dosdude1/MPx-CPU-Board-744x/README.md

# MPx CPU Board 744x
A custom CPU board designed for Power Macintosh G4 systems. This board is designed for use with 744x-series PowerPC G4 CPUs, such as the 7445, 7447, and 7448.

This repository is a work in progress, the design is not in a functional state at this point.
