dosdude1/MPx-CPU-Board-744x/MPx-CPU-Board-Dual-744x/cpu-misc.kicad_sch

## KiCad design MPx-CPU-Board-Dual-744x/cpu-misc.kicad_sch (2023-09-16)

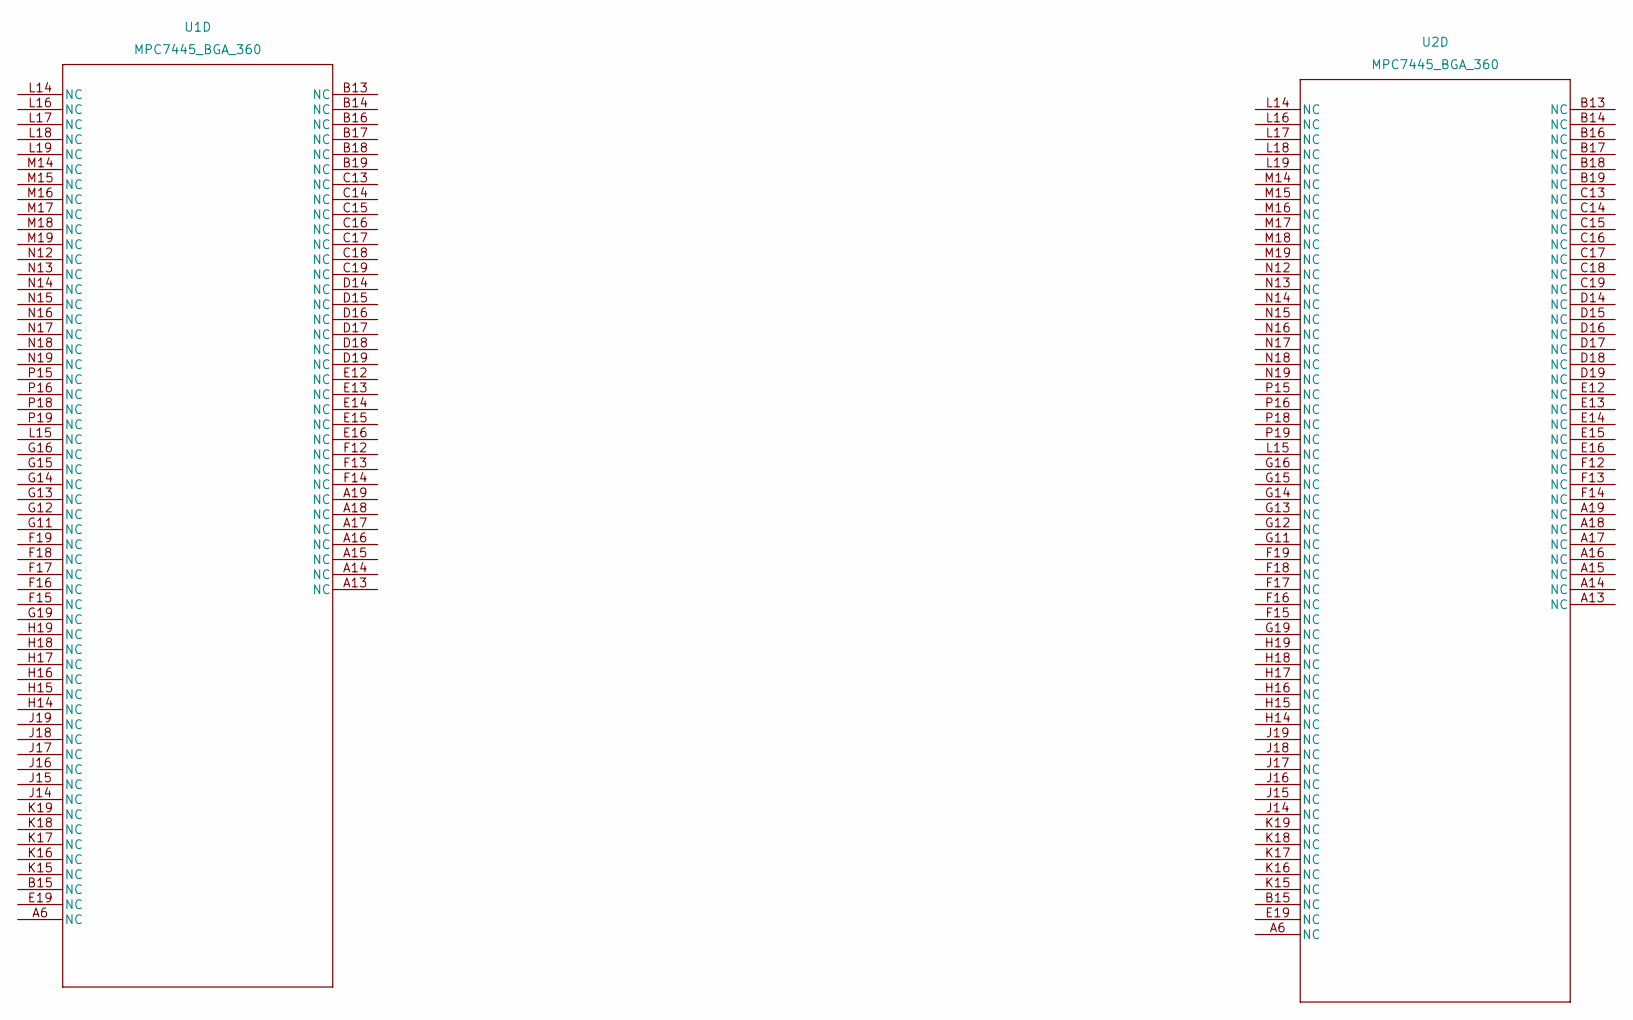
[picture p1: schematic cpu-misc.kicad_sch]

Parts:
U1, U2: MPC7445_BGA_360
